alcdaniel/kefir-automation/README.md

# Automatic Kefir Jar Lid · Arduino Nano

Firmware and build guide for a **3D-printed jar lid that automates milk kefir fermentation**. Pick 12, 24 or 36 hours on a small OLED and, when the countdown ends, a micro servo releases a spring-loaded plunger that lifts the grains out of the milk. No Wi-Fi, no apps and no accounts: an Arduino Nano, three buttons and a display.

<p align="center">
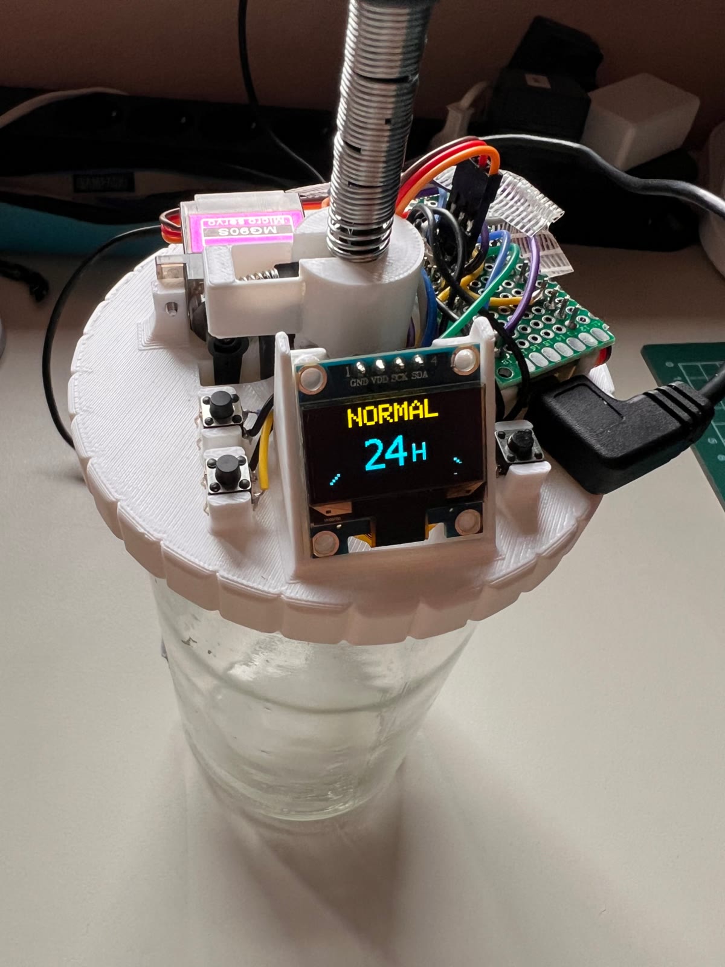
[picture p1: docs/images/photo-lid-top.jpg]
Printed jar lid on a glass jar: the OLED shows NORMAL 24H next to three push buttons, the servo, the spring plunger and the Arduino Nano on perfboard
  
</p>

## Gallery

### 3D model (Fusion 360)

| Overview | Front | Close-up |
| :---: | :---: | :---: |
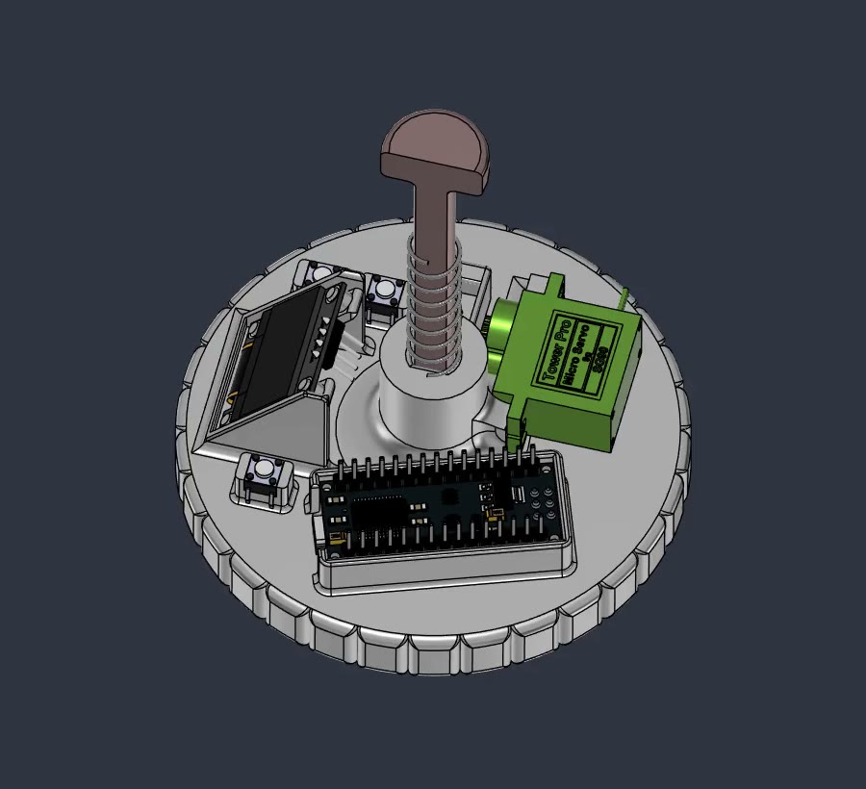
[picture p2: docs/images/render-overview.jpg]
3D render of the lid from above with the OLED stand, buttons, servo, plunger and Arduino Nano
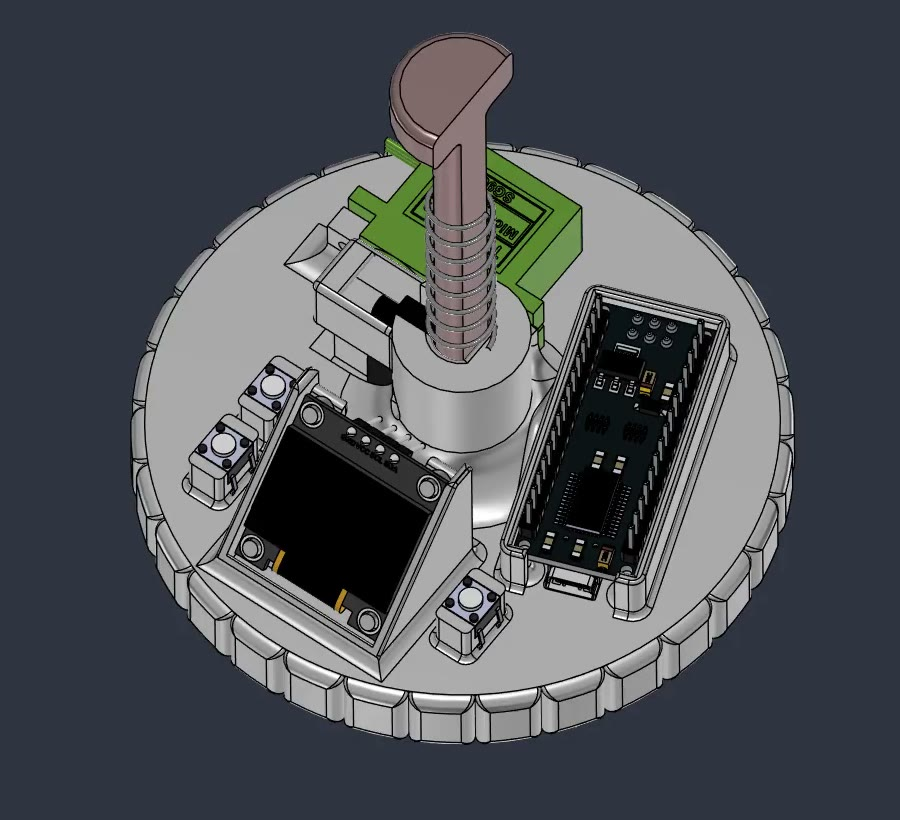
[picture p3: docs/images/render-front.jpg]
3D render of the front of the lid showing the OLED, the buttons and the Nano
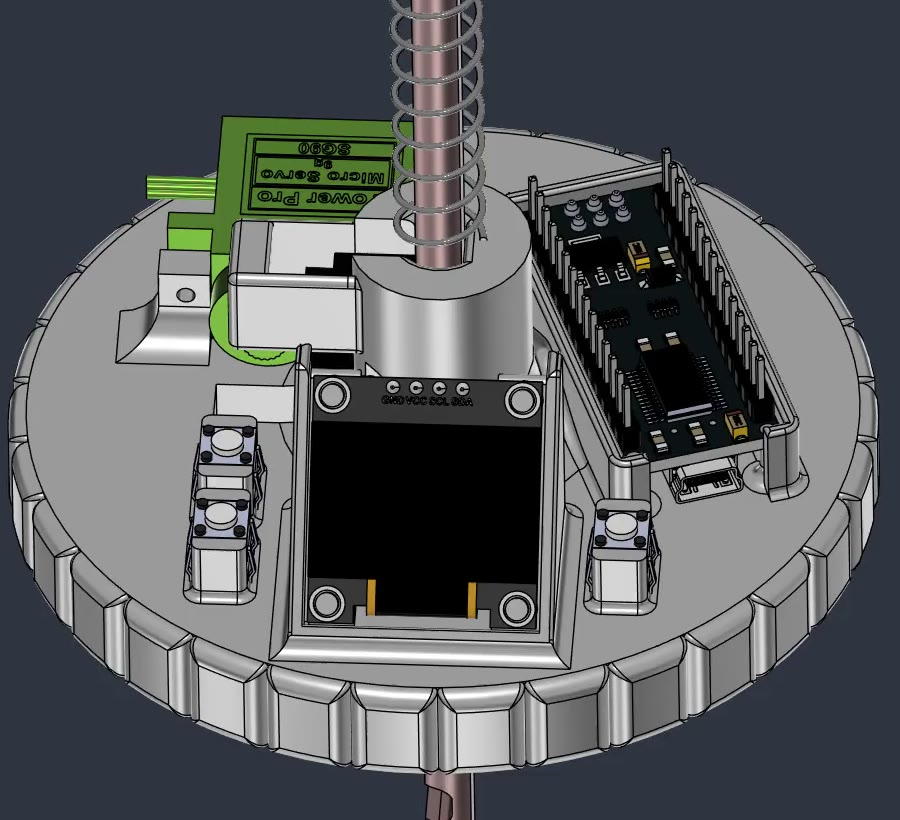
[picture p4: docs/images/render-top.jpg]
Close-up render of the plunger spring, the servo latch, the OLED and the Nano
|  |  |  |

### Real build

| Finished lid | Countdown running | Plunger released |
| :---: | :---: | :---: |
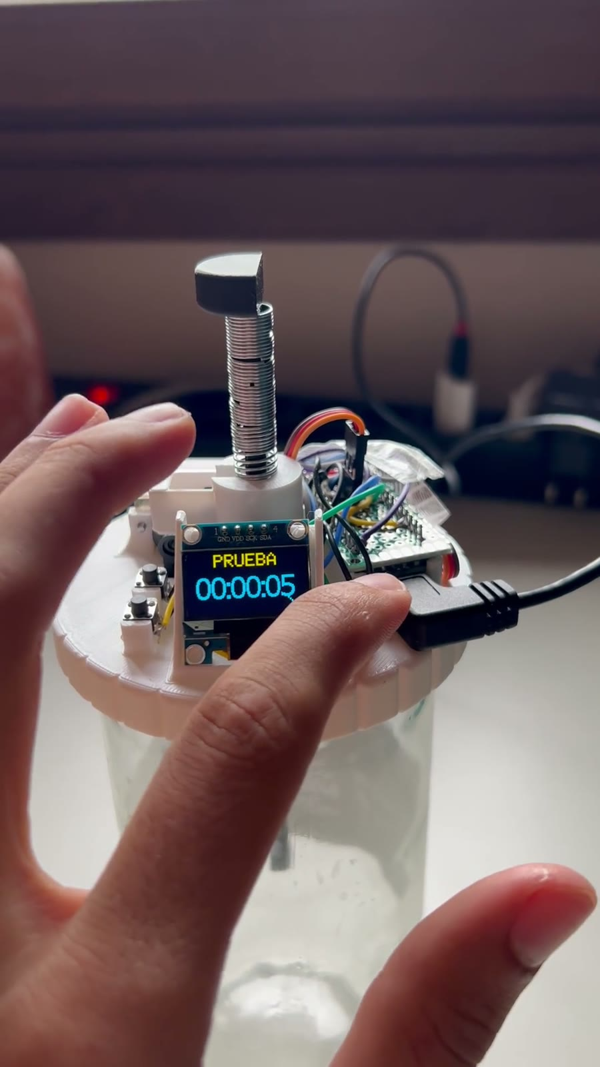
[picture p5: docs/images/photo-countdown.jpg]
Lid on the jar during the 5-second test countdown, plunger down
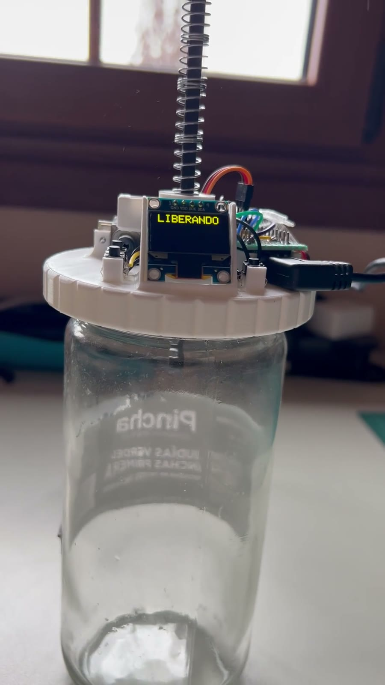
[picture p6: docs/images/photo-released.jpg]
Lid on the jar after the release, with the plunger raised by its spring
| Finished lid on a glass jar showing the NORMAL 24 h preset |  |  |

The two photos on the right were taken with an earlier firmware build that showed Spanish labels on the display; the current firmware shows the same screens in English (TEST, RELEASING…).

> **Food and mechanical safety.** Keep all electronics on top of the lid, away from the wet area. Any part that touches the milk or the grains must be food-safe and easy to clean. Always test the mechanism without milk before using it. The timer does not replace keeping an eye on your kefir: temperature, the amount of milk and the state of the grains all change the result.

## Repository contents

| Path | Description |
| --- | --- |
| [`KefirJarLidNano/KefirJarLidNano.ino`](KefirJarLidNano/KefirJarLidNano.ino) | Arduino Nano firmware. |
| [`KefirJarLidNano/README.md`](KefirJarLidNano/README.md) | Quick flashing guide. |
| [`BOM.md`](BOM.md) | Bill of materials with links to several shops. |
| [`docs/images/`](docs/images) | Photos, 3D renders and the wiring diagram. |
| `README.md` | This full guide. |
| [`LICENSE.md`](LICENSE.md) | CC BY-NC-SA 4.0 licence notice. |

The STL models of the lid, the plunger and the release clamp are distributed separately in the project's downloadable package.

## Bill of materials

See **[BOM.md](BOM.md)** for the full list with purchase links (Arduino Store, Amazon, AliExpress and eBay). In short:

**Electronics**

- Classic Arduino Nano (ATmega328P, 5 V, 16 MHz).
- 0.96" SSD1306 OLED, 128×64 pixels, I2C (address `0x3C` or `0x3D`).
- 9 g micro servo (SG90, MG90S or similar).
- 3 tactile push buttons (up, down and select).
- Jumper (Dupont) wires and some simple soldering.
- 5 V USB supply for the Nano and, recommended, a 5 V supply of at least 1 A for the servo.
- Optional: a 470–1000 µF capacitor to absorb the servo's current peaks.

**Mechanics**

- 3D-printed parts: lid, plunger and release clamp.
- Compression spring, **8 mm diameter and about 10 cm** long, to raise the plunger.
- Spring of about **3 mm diameter and 5 cm**, cut to size, for the release latch.
- 2 **M3** screws (servo) and 1 **M2** screw (release lock).
- A glass jar with a **TO 77** screw top.

## Wiring

<p align="center">
  Wiring diagram: OLED VDD, GND, SDA and SCK to 5V, GND, A4 and A5; buttons to D2, D3 and D4 with the other leg to GND; servo signal to D9 with an external 5 V supply and common ground
</p>

| Component | Component pin | Arduino Nano | Note |
| --- | --- | --- | --- |
| OLED | VDD / VCC | 5V | Most 0.96" modules accept 3.3 V and 5 V; check yours. |
| OLED | GND | GND | Common ground. |
| OLED | SDA | A4 | I2C data (fixed pin on the Nano). |
| OLED | SCK / SCL | A5 | I2C clock (fixed pin on the Nano). |
| Servo | Signal (orange/yellow) | D9 | PWM control. |
| Servo | +5 V (red) | External 5 V supply | ≥ 1 A recommended. |
| Servo | GND (brown/black) | GND | Also joined to the external supply's GND. |
| Up button | One leg | D2 | Other leg to GND. |
| Down button | One leg | D3 | Other leg to GND. |
| Select button | One leg | D4 | Other leg to GND. |

- The buttons use the Nano's **internal pull-up resistors**: each one goes only between its pin and GND, with no external resistor.
- On a four-leg tactile switch, the two legs on each side are already connected. Wire it using legs on **opposite sides**; otherwise pressing it changes nothing.
- If your OLED module only accepts 3.3 V signals, do not connect SDA/SCL directly to the 5 V Nano.

### Powering the servo

A servo can draw current peaks that reset the Nano when it is powered from the Nano's 5V pin while on USB. The reliable setup is:

1. Power the Nano over USB.
2. Power the servo's red wire from a 5 V supply of at least 1 A.
3. Join that supply's GND to the Nano's GND.
4. Connect the servo signal to D9.

A 470–1000 µF capacitor between 5 V and GND, close to the servo, helps absorb those peaks.

## Flashing the firmware

1. Install [Arduino IDE 2](https://www.arduino.cc/en/software).
2. In **Tools → Manage Libraries**, install:
   - `SSD1306Ascii` (by Bill Greiman).
   - `Servo`.

   `Wire` and `EEPROM` ship with the Arduino AVR core.
3. Open [`KefirJarLidNano/KefirJarLidNano.ino`](KefirJarLidNano/KefirJarLidNano.ino). The folder must keep the same name as the `.ino` file.
4. In **Tools → Board**, select **Arduino Nano**.
5. In **Tools → Processor**, select **ATmega328P**. If uploading fails on a clone, try **ATmega328P (Old Bootloader)**.
6. Select the Nano's port in **Tools → Port** and click **Upload**.

At start-up, the Serial Monitor (115200 baud) reports the address where the OLED was found and prints the list of commands.

## First start: language

The first time the lid starts, it asks for the language: press **up or down** to switch between **ENGLISH** and **ESPANOL**, then **select** to confirm. The choice is saved, so this only appears once (or again after a firmware update that resets the EEPROM).

## Using the buttons

- **Up / down**: move through **TEST** (5 s), **QUICK** (12 h), **NORMAL** (24 h), **LONG** (36 h) and **MENU**.
- **Select**: starts the option on screen; on **MENU** it opens the options. Buttons act when released, so a press never triggers a second action on the next screen. The 5-second test runs the full release cycle so you can check the mechanism.
- **Hold select for 1.5 s** on a preset: edit its duration with the same blinking editor as in MENU → TIME (hours, then tens and units of the minutes, so any length down to one minute). Select saves it and returns to the home screen.
- **Hold up or down for 1.5 s** (from anywhere on the home screen): also opens **MENU**.
- **MENU** (options):
  - `TIME`: lists **QUICK**, **NORMAL** and **LONG** with their times (up/down to choose, **EXIT** to go back). Select on a preset starts editing it. The time fills the screen and the field being edited **blinks**: first the **hours**, then the **tens** and the **units** of the minutes, so you can set any duration down to one minute. Up/down change the blinking field (hours by 1, tens 0-5, units 0-9). Hold up or down and the number keeps changing quickly, so you do not have to press it again and again. Each select moves on to the next field; the last select saves and returns to the list. Nothing starts.
  - `SERVO`: sets the **CLOSED** angle, the **OPEN** angle and how many seconds it stays open (**HOLD**).
  - `LANGUAGE`: switches between English and Spanish. The footer shows the language it will switch to.
  - `EXIT`: back to the home screen.
- **While fermenting**: **up** adds 30 minutes (up to 72 hours in total; not during the 5-second test). Holding **select** for 1.5 s **cancels**: the servo releases the grains for the configured hold time and then closes, the same as when the timer reaches zero.
- The home screen opens on the last preset you started, so you can start it again with one press of select.

The character is a kefir grain called **KEFI**. It says hello when the lid starts. It has a few animations:

- **Start**: when a fermentation starts the grain appears in the middle of the screen, hops and winks, then slides to its place and the time shows.
- **Every minute**: the grain winks and hops, then the new time appears.
- **Blinks** now and then while it is on screen.
- **Releasing**: the grain shakes while the servo moves, with a surprised face.
- **Done**: when the grains are released the grain bobs and sparkles in the middle of the screen, with no text. After 30 seconds without a press the screen dims; any button returns to the home screen.
- **No time set**: a worried grain shakes once.

The menus are not animated, so they respond straight away.

## Power saving

After 30 seconds without touching a button (or sending a serial command) the screen drops to its lowest brightness and shows one thing, depending on where you are:

- **Fermenting**: the time left.
- **Home screen**: the time of the preset you are on (or the test, or the word MENU).
- **Options, time, servo, language**: the name of that screen (for example OPTIONS or SERVO).
- **Finished**: just the grain.

The screen is never completely blank: every 8 seconds a small mark flashes in the bottom-right corner, so you know the lid is on. Any button wakes it to full brightness; that press only wakes the screen and does not also act on what is shown. The screen also wakes by itself when the fermentation ends and the grains are released.

The servo is also disconnected while the lid is closed, since it holds nothing there. It is connected only for the release (and while you calibrate the angles in SERVO), which saves power.

## Using it without buttons: serial console

Connect the Nano over USB, open the **Serial Monitor** at **115200 baud** and choose `Newline` (or `Both NL & CR`).

| Command | Action |
| --- | --- |
| `HELP` | Lists every command. |
| `STATUS` | Shows the settings and the remaining time. |
| `DURATION 14` | Saves a 14-hour duration. |
| `DURATION 12 30` | Saves 12 hours and 30 minutes. |
| `START` | Starts with the saved duration. |
| `START 14` / `START 12 30` | Saves the given duration and starts. |
| `ADD` | Adds 30 minutes to the running fermentation. |
| `CANCEL` | Cancels and releases the grains now, like the timer does at zero. |
| `TEST` | Runs one open-and-close cycle of the servo. |
| `CLOSE` | Moves the servo to the closed position. |
| `CLOSED 0` | Saves 0° as the closed position and moves the servo there. |
| `RELEASE 60` | Saves 60° as the release position. |
| `HOLD 3` | Saves 3 seconds held open. |

Commands are case-insensitive. The Spanish aliases from earlier versions (`AYUDA`, `INICIAR`, `PAUSA`…) are still accepted. Buttons and console can be used at the same time, and every button press is echoed on the Serial Monitor, which is handy to check the wiring.

## First calibration

The defaults are **0° closed**, **60° open** and **3 s** held open. Every build needs its own values:

1. Fit the lid without milk or grains.
2. In `OPTIONS → SERVO → CLOSED`, set the angle where the plunger is held without the servo straining.
3. In `OPEN`, set the angle where the plunger is released reliably.
4. Run `TEST` several times and check that nothing rubs or jams.
5. Only when it works repeatably, add the milk and the grains.

## Power cuts

Settings and the countdown are saved to the Nano's EEPROM when starting, adding time or cancelling, and every 5 minutes while fermenting (this limits EEPROM wear). After a power cut the countdown resumes from the last saved point, so up to 5 minutes can be lost: **time without power is not counted**. If the power goes out while the grains are being released, they are not released again when it returns; the servo has to be moved by hand. Counting power cuts precisely would require a battery-backed real-time clock such as a DS3231.

## Troubleshooting

**The display stays blank.** Check that SDA goes to A4, SCL to A5, and that VDD and GND are correct. The Serial Monitor reports whether the OLED was found at `0x3C` or `0x3D`; the console keeps working without a display.

**A button does nothing.** Open the Serial Monitor: every press should print `Button pressed`. If it does not, check that the wire reaches D2, D3 or D4 and that you used legs on opposite sides of the switch.

**The Nano resets when the servo moves.** The servo is drawing more current than USB can supply. Power it from a separate 5 V supply with a common GND and add the capacitor.

## Licence

© 2026 Daniel Álvarez Conde. Licensed under [Creative Commons Attribution-NonCommercial-ShareAlike 4.0 International (CC BY-NC-SA 4.0)](https://creativecommons.org/licenses/by-nc-sa/4.0/): firmware and documentation can be shared and adapted for non-commercial purposes if you credit the author, link to the licence and to the [original project page](https://www.alcdaniel.com/store/product/?slug=kefir-automation-jar-lid), indicate changes and share adaptations under the same licence. Third-party libraries keep their own licences. See [LICENSE.md](LICENSE.md).
