alcdaniel/kefir-automation/BOM.md

# Bill of materials

Everything you need to build the automatic kefir jar lid, besides the 3D-printed parts. Each link opens a **search** in a different shop so you can compare options and choose the one that ships best to your country. Prices change often and are intentionally not listed; check the notes before buying.

| Component | Qty | Notes | Where to buy |
| --- | --- | --- | --- |
| Arduino Nano (ATmega328P, 5 V) | 1 | Classic Nano. Clones work too (they may need the Old Bootloader option). | [Arduino Store](https://store.arduino.cc/products/arduino-nano) · [Amazon](https://www.amazon.com/s?k=Arduino%20Nano%20ATmega328P) · [AliExpress](https://www.aliexpress.com/w/wholesale-Arduino-Nano-ATmega328P.html) · [eBay](https://www.ebay.com/sch/i.html?_nkw=Arduino%20Nano%20ATmega328P) |
| 0.96" SSD1306 OLED, 128×64, I2C | 1 | 4-pin I2C version (GND, VDD, SCK, SDA). Yellow/blue or single colour. | [Amazon](https://www.amazon.com/s?k=SSD1306%200.96%20OLED%20128x64%20I2C) · [AliExpress](https://www.aliexpress.com/w/wholesale-SSD1306-0.96-OLED-128x64-I2C.html) · [eBay](https://www.ebay.com/sch/i.html?_nkw=SSD1306%200.96%20OLED%20128x64%20I2C) |
| 9 g micro servo (SG90 or MG90S) | 1 | The MG90S has metal gears and is more durable; the SG90 also works. | [Amazon](https://www.amazon.com/s?k=MG90S%20SG90%20micro%20servo%209g) · [AliExpress](https://www.aliexpress.com/w/wholesale-MG90S-SG90-micro-servo-9g.html) · [eBay](https://www.ebay.com/sch/i.html?_nkw=MG90S%20SG90%20micro%20servo%209g) |
| 6×6 mm tactile push buttons | 3 | Up, down and select. | [Amazon](https://www.amazon.com/s?k=6x6mm%20tactile%20push%20button) · [AliExpress](https://www.aliexpress.com/w/wholesale-6x6mm-tactile-push-button.html) · [eBay](https://www.ebay.com/sch/i.html?_nkw=6x6mm%20tactile%20push%20button) |
| Compression spring Ø8 mm × 100 mm | 1 | Raises the plunger. An assortment kit is handy. | [Amazon](https://www.amazon.com/s?k=compression%20spring%208mm%20diameter%20100mm) · [AliExpress](https://www.aliexpress.com/w/wholesale-compression-spring-8mm-diameter-100mm.html) · [eBay](https://www.ebay.com/sch/i.html?_nkw=compression%20spring%208mm%20diameter%20100mm) |
| Spring Ø3 mm × 50 mm | 1 | Cut to size for the release latch. | [Amazon](https://www.amazon.com/s?k=compression%20spring%203mm%20diameter%2050mm) · [AliExpress](https://www.aliexpress.com/w/wholesale-compression-spring-3mm-diameter-50mm.html) · [eBay](https://www.ebay.com/sch/i.html?_nkw=compression%20spring%203mm%20diameter%2050mm) |
| M3 and M2 screws | 2 × M3 + 1 × M2 | M3 for the servo, M2 for the release lock. Assortment kits cover every length. | [Amazon](https://www.amazon.com/s?k=M3%20M2%20screw%20assortment%20kit) · [AliExpress](https://www.aliexpress.com/w/wholesale-M3-M2-screw-assortment-kit.html) · [eBay](https://www.ebay.com/sch/i.html?_nkw=M3%20M2%20screw%20assortment%20kit) |
| Jumper (Dupont) wires | 1 pack | Female-female and male-female. | [Amazon](https://www.amazon.com/s?k=dupont%20jumper%20wires) · [AliExpress](https://www.aliexpress.com/w/wholesale-dupont-jumper-wires.html) · [eBay](https://www.ebay.com/sch/i.html?_nkw=dupont%20jumper%20wires) |
| Perfboard (optional) | 1 | Tidies up the soldered connections. | [Amazon](https://www.amazon.com/s?k=perfboard%20prototype%20pcb) · [AliExpress](https://www.aliexpress.com/w/wholesale-perfboard-prototype-pcb.html) · [eBay](https://www.ebay.com/sch/i.html?_nkw=perfboard%20prototype%20pcb) |
| Glass jar with TO 77 screw top | 1 | The printed lid replaces the original one. | [Amazon](https://www.amazon.com/s?k=TO%2082%20glass%20jar) · [AliExpress](https://www.aliexpress.com/w/wholesale-TO-82-glass-jar.html) · [eBay](https://www.ebay.com/sch/i.html?_nkw=TO%2082%20glass%20jar) |
| 5 V USB power supply (≥ 1 A) and USB cable | 1 | Classic Nanos use Mini-USB; some clones use USB-C. A second 5 V supply for the servo is recommended. | [Amazon](https://www.amazon.com/s?k=5V%202A%20USB%20power%20supply) · [AliExpress](https://www.aliexpress.com/w/wholesale-5V-2A-USB-power-supply.html) · [eBay](https://www.ebay.com/sch/i.html?_nkw=5V%202A%20USB%20power%20supply) |
| 470–1000 µF capacitor (optional) | 1 | Between servo 5 V and GND to absorb current peaks. | [Amazon](https://www.amazon.com/s?k=1000uF%2016V%20electrolytic%20capacitor) · [AliExpress](https://www.aliexpress.com/w/wholesale-1000uF-16V-electrolytic-capacitor.html) · [eBay](https://www.ebay.com/sch/i.html?_nkw=1000uF%2016V%20electrolytic%20capacitor) |

## 3D-printed parts

| Part | Qty | Notes |
| --- | --- | --- |
| Lid with TO 77 thread and mounts | 1 | Holds the OLED, buttons, servo, Nano and plunger. |
| Plunger, 15 cm or 20 cm | 1 | Print only the one that fits your jar height. |
| Release clamp | 1 | Part of the servo release latch. |

Use a food-safe material for any part that touches the milk or the grains.
