alcdaniel/kefir-automation/(commit log)

2026-10-06 Add KefirAutomaticoNano firmware and README documentation
    - Implemented the main firmware for the Kefir Automatico project using Arduino Nano.
    - Integrated OLED display support for user interface.
    - Added servo control for fermentation process.
    - Included button handling for user interaction.
    - Implemented EEPROM storage for configuration and timer state.
    - Created README.md with setup instructions, wiring details, and usage guidelines.
2026-10-15 Update README.md with detailed button functionality, language selection, and power saving features
2026-10-30 Update BOM and README to reflect change from TO 82 to TO 77 screw top for glass jar
